Sandman6z/XDS100v3/data/原理图+PCB_PDF档+BOM清单/YFXDS100V3仿真器bom.xlsx

集成IC标号 | IC名称 | 是否需要焊接 | 电阻标号 | 电阻阻值 | 是否需要焊接 | 电阻标号 | 电阻阻值 | 是否需要焊接 | 电容标号 | 电容型号 | 电容阻值 | 备注
U1 | TLV1117-33 |  | R1 | 0 |  | R33 | 51 |  | C1 | 片式多层陶瓷电容 | 4.7uF
U2 | FT2232HL |  | R2 | 0 | 没有R34 | R34 | ? |  | C2 | 片式多层陶瓷电容 | 0.1uF
U3 | AT93C46DN |  | R3 | 470 |  | R35 | 51 |  | C3 | 片式多层陶瓷电容 | 0.1uF
U4 | TLV70015 | 不用焊接！ | R4 | 1K |  | R36 | 51 |  | C4 | 片式多层陶瓷电容 | 4.7uF
U5 | 100MHZ有源晶振7050 | 不用焊接！ | R5 | 1K |  | R37 | 10K |  | C5 | 片式多层陶瓷电容 | 0.1uF
U6 | A3PN125-VQG100 | 不用焊接！ | R6 | 1K |  | R38 | 51 |  | C6 | 片式多层陶瓷电容 | 4.7uF
U7 | OPA2363 | 不用焊接！ | R7 | 1K |  | R39 | 27 |  | C7 | 片式多层陶瓷电容 | 0.1uF
Q1 | 晶振12.000MHz |  | R8 | 0 |  | R40 | 51 |  | C8 | 片式多层陶瓷电容 | 0.1uF
Q2 | SS8050 |  | R9 | 12K |  | R41 | 51 |  | C9 | 片式多层陶瓷电容 | 0.1uF
D1 | LED0805 |  | R10 | 1K |  | R42 | 51 |  | C10 | 片式多层陶瓷电容 | 0.1uF
D2 | LED0805 |  | R11 | 1K |  | R43 | 27 |  | C11 | 片式多层陶瓷电容 | 0.1uF
D3 | 没有D3 |  | R12 | 1K |  | R44 | 470 |  | C12 | 片式多层陶瓷电容 | 0.1uF
D4 | LED0805 |  | R13 | 1K |  | R45 | 470 |  | C13 | 片式多层陶瓷电容 | 0.1uF
D5 | LED0805 |  | R14 | 2.2K |  | R46 | 470 |  | C14 | 片式多层陶瓷电容 | 0.1uF
D6 | 1N4148 |  | R15 | 10K |  | R47 | 1K |  | C15 | 片式多层陶瓷电容 | 0.1uF
JTAG口 | 不用焊接!! |  | R16 | 220 |  | R48 | 10K |  | C16 | 片式多层陶瓷电容 | 0.1uF
JTAG_14 | 牛角连接器/2X7 |  | R17 | 51 |  | R49 | 120K |  | C17 | 片式多层陶瓷电容 | 0.1uF
JTAG_20 | 牛角连接器/2X20 |  | R18 | 5.1K |  | R50 | 10K |  | C18 | 片式多层陶瓷电容 | 0.1uF
F1 | 500MA自恢复保险丝 |  | R19 | 51 |  | R51 | 0 |  | C19 | 片式多层陶瓷电容 | 0.1uF
USB1 | USB B母 90° |  | R20 | 10K |  | R52 | 120K |  | C20 | 片式多层陶瓷电容 | 0.1uF
 |  | 没有R21 | R21 | ? |  | R53 | 10K |  | C21 | 片式多层陶瓷电容 | 0.1uF
 |  |  | R22 | 0 |  | R54 | 10K |  | C22 | 片式多层陶瓷电容 | 0.1uF
 |  |  | R23 | 10K |  | R55 | 5.1K |  | C23 | 片式多层陶瓷电容 | 0.1uF
 |  |  | R24 | 220 |  | R56 | 10K |  | C24 | 片式多层陶瓷电容 | 0.1uF
 |  |  | R25 | 5.1K |  | R57 | 120K |  | C25 | 片式多层陶瓷电容 | 0.1uF
 |  |  | R26 | 51 | 不用焊接！ | R58 |  |  | C26 | 片式多层陶瓷电容 | 4.7uF
 |  |  | R27 | 5.1K |  |  |  |  | C27 | 片式多层陶瓷电容 | 4.7uF
 |  |  | R28 | 10K |  |  |  |  | C28 | 片式多层陶瓷电容 | 12nF
 |  |  | R29 | 1K |  |  |  |  | C29 | 片式多层陶瓷电容 | 0.1uF
 |  |  | R30 | 220 |  |  |  |  | C30 | 片式多层陶瓷电容 | 4.7uF
 |  |  | R31 | 220 |  |  |  |  | C31 | 片式多层陶瓷电容 | 0.1uF
 |  |  | R32 | 10K |  |  |  |  | C32 | 片式多层陶瓷电容 | 0.1uF
 |  |  |  |  | 使用钽电容的时候一定要主要正负极！！ |  |  |  | CT1 | 片式钽电容 | 10uF | 可以直接用10uF的陶瓷电容代替
 |  |  |  |  | 原理图中CT3,CT4,CT5钽电容正负极是反了的， |  |  |  | CT2 | 片式钽电容 | 22uF | 可以直接用22uF的陶瓷电容代替
 |  |  |  |  | 焊接时，千万要注意！可以使用陶瓷电容代替！ |  |  |  | CT3 | 片式钽电容 | 4.7uF | 可以直接用4.7uF的陶瓷电容代替
 |  |  |  |  | 钽电容封装上有一个小点的就是正极！！！ |  |  |  | CT4 | 片式钽电容 | 4.7uF | 可以直接用4.7uF的陶瓷电容代替
 |  |  |  |  |  |  |  |  | CT5 | 片式钽电容 | 4.7uF | 可以直接用4.7uF的陶瓷电容代替
