Sandman6z/XDS100v3/data/原理图+PCB_PDF档+BOM清单/XDS100V3的PCB丝印层.pdf

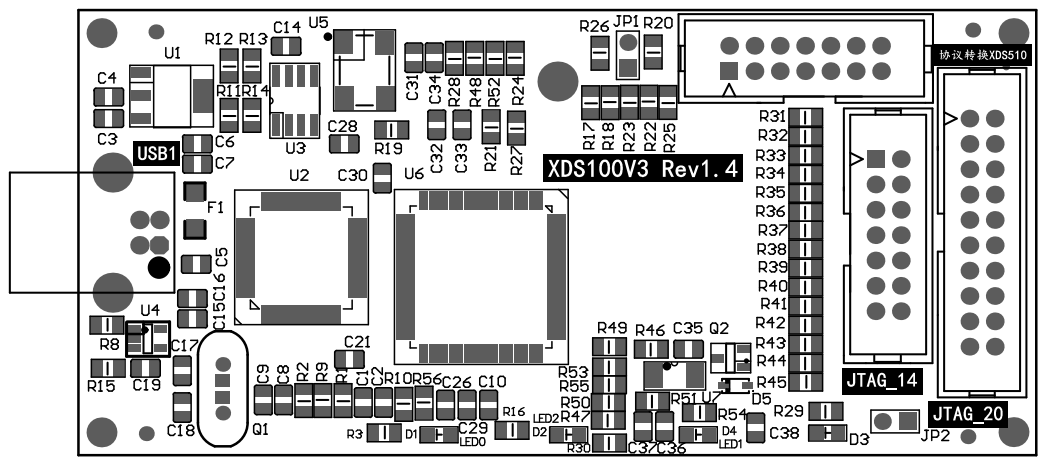
[picture p19: page 1]
