Sandman6z/XDS100v3/(list of files, drawings)

Other design files:
FPGA.SchDoc
Others.SchDoc
Port.SchDoc
Power.SchDoc
UART.SchDoc
XDS100v3.PcbDoc
XDS100v3.PrjPcb
