Sandman6z/XDS100v3/(commit log)

2023-08-16 add main component, start the project!
    [FPGA.SchDoc, Power.SchDoc, UART.SchDoc, XDS100v3.PrjPcb]
2023-08-16 add "data" folder
    [YFXDS100V3仿真器bom.xlsx]
2023-08-21 add FPGA to sch
    [FPGA.SchDoc, Power.SchDoc, UART.SchDoc]
2023-08-21 add res
    [FPGA.SchDoc]
2023-08-24 almost add FPGA sheet sch
    [FPGA.SchDoc, Others.SchDoc, XDS100v3.PcbDoc, XDS100v3.PrjPcb]
2023-08-25 change all offsheet name
    [FPGA.SchDoc, Port.SchDoc, UART.SchDoc, XDS100v3.PrjPcb]
2023-08-25 commit again
    [FPGA.SchDoc, Port.SchDoc, UART.SchDoc, XDS100v3.PrjPcb]
2023-08-25 before version is under encrypted system, cannot use. This version is good.
    [FPGA.SchDoc, Port.SchDoc, UART.SchDoc, XDS100v3.PrjPcb]
2023-08-29 add wurth Cap
    [Power.SchDoc, UART.SchDoc]
2023-08-29 update component library
    [FPGA.SchDoc, Others.SchDoc, Port.SchDoc, Power.SchDoc, UART.SchDoc, XDS100v3.PcbDoc]
